mdexdev01/MatESP32_18x11x2/config_ESP32_S3_N16R8.png

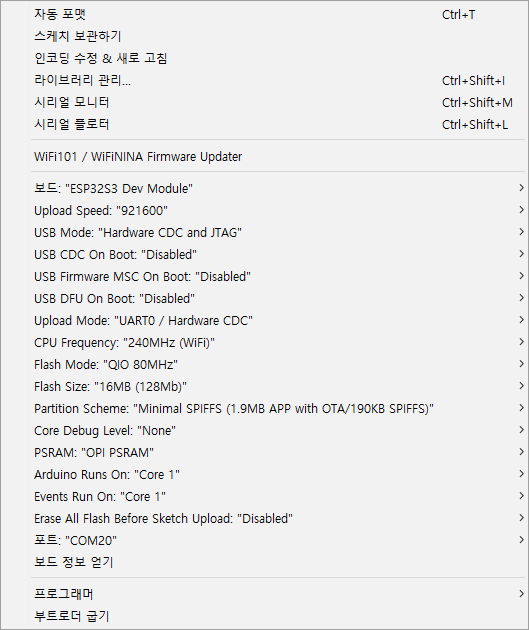
config_ESP32_S3_N16R8.png
