mdexdev01/MatESP32_18x11x2/prj24-brandContents/Proc_BrandCon_10x12x3/Save_ScreenShot/John Doe/20241016-135037_John Doe_MEMO.png

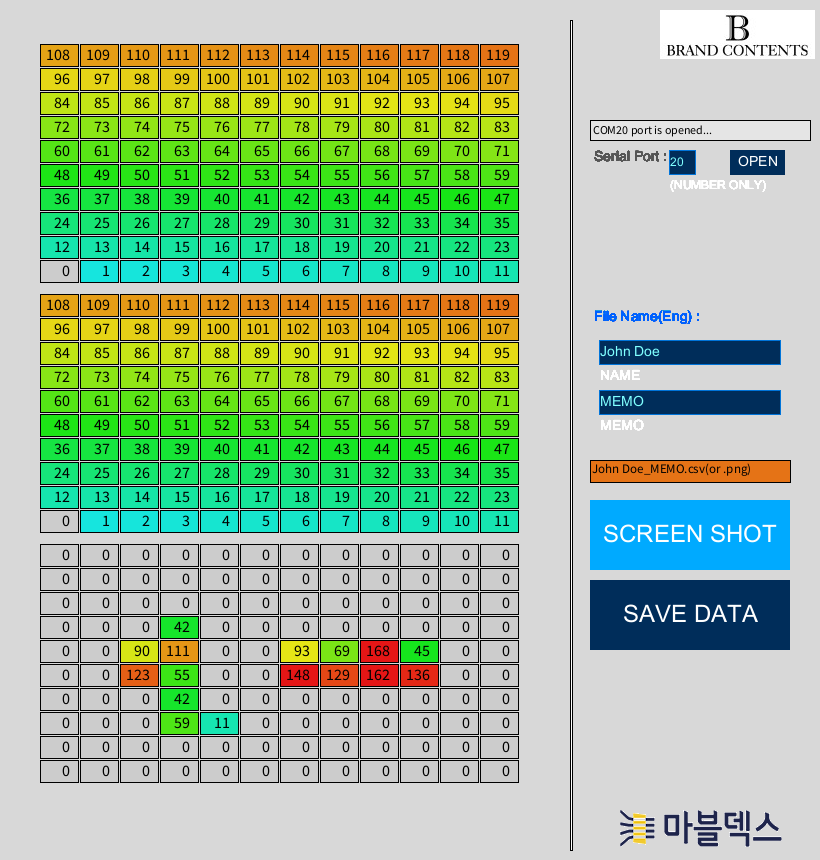
prj24-brandContents/Proc_BrandCon_10x12x3/Save_ScreenShot/John Doe/20241016-135037_John Doe_MEMO.png
