mdexdev01/MatESP32_18x11x2/prj24-luxtep-MAT_V3/Resources/image-dip, tact, buzzer.jpg

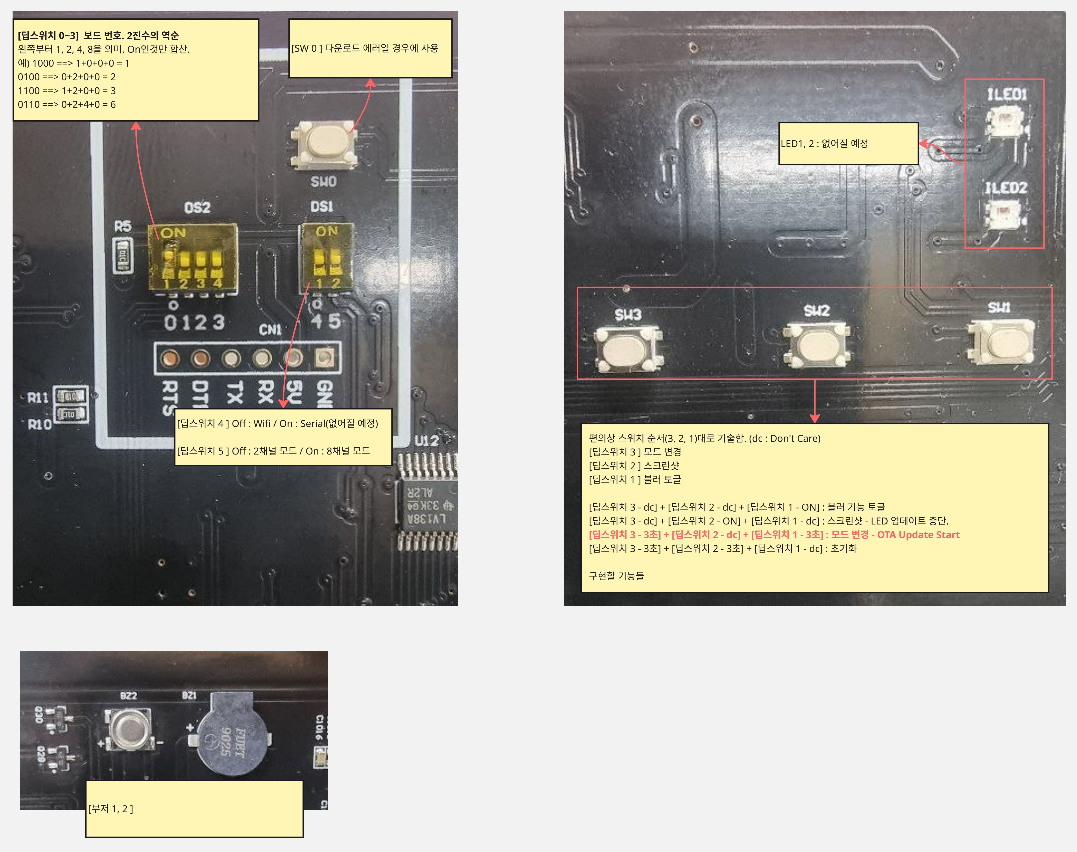
prj24-luxtep-MAT_V3/Resources/image-dip, tact, buzzer.jpg
