mdexdev01/MatESP32_18x11x2/prj24-luxtep-MAT_V3/Resources/luxtep-밟은사진-01.jpg

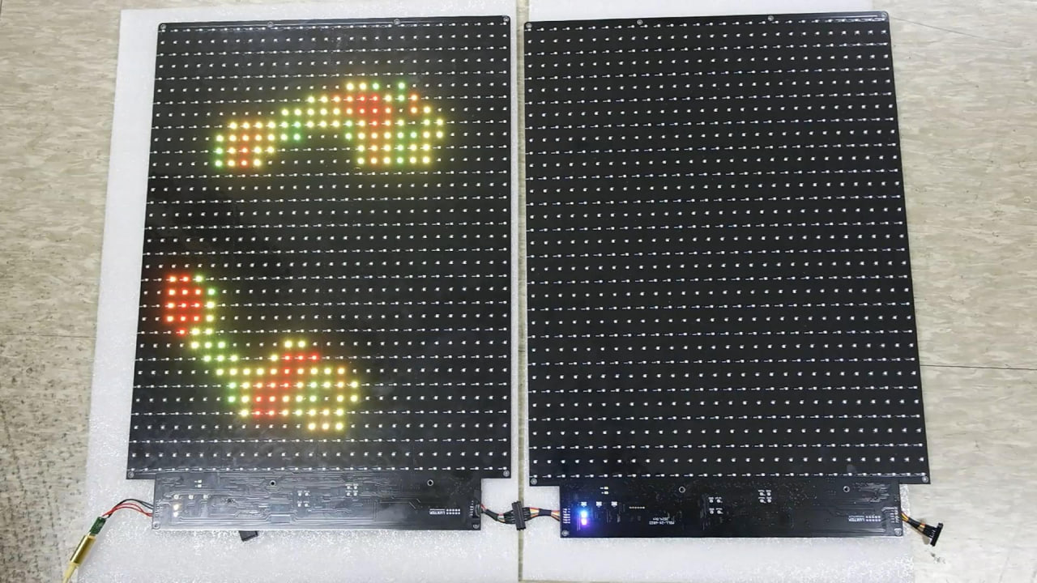
prj24-luxtep-MAT_V3/Resources/luxtep-밟은사진-01.jpg
