mdexdev01/MatESP32_18x11x2/prj24-luxtep-MAT_V3/Resources/USB PD trigger module.jpg

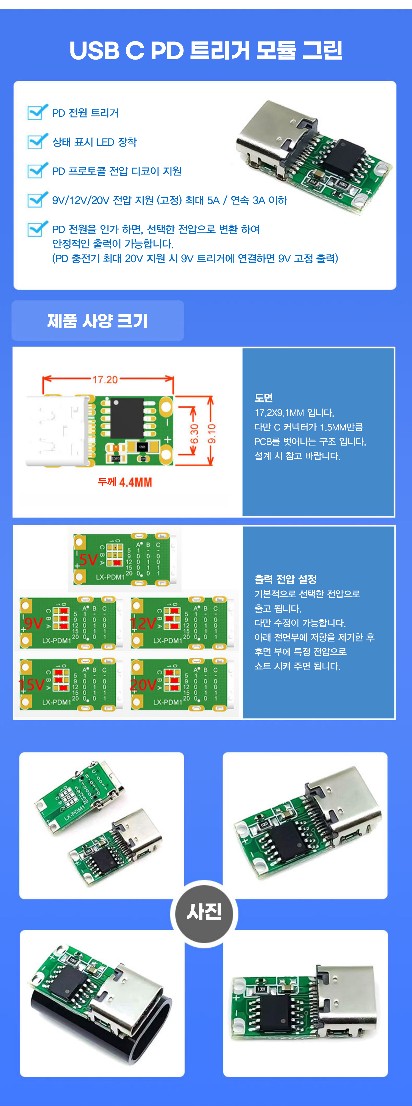
prj24-luxtep-MAT_V3/Resources/USB PD trigger module.jpg
