mdexdev01/MatESP32_18x11x2/prj24-luxtep-MAT_V3/Resources/Part List MDLL-24-6822 Rev1.0 20241112.xlsx

Sheet: Bill of Materials-PCB_MDLL-24-6
No. | Comment | Description | Designator | Quantity | MFPN | Manufacturer | Remark
1 | BLM21PG221SN1 |  | BD1 | 1 | BLM21PG221SN1D | muRata | https://www.lcsc.com/product-detail/Ferrite-Beads_Murata-Electronics-BLM21PG221SN1D_C85840.html
2 | FUET-9025 | DC Buzzer, 2.7KHz | BZ1 | 1 | FUET-9025-3.6V | FUET | https://www.lcsc.com/product-detail/Buzzers_FUET-FUET-9025-3-6V_C417432.html
3 | FUET-5018 | DC Buzzer, 4KHz | BZ2 | 1 | FUET-5018 | FUET | https://www.lcsc.com/product-detail/Buzzers_FUET-FUET-5018_C391028.html
4 | 104 | Cap 1608 | C0, C1, C2, C3, C4, C5, C6, C7, C8, C9, C10, C11, C12, C13, C14, C15, C16, C17, C18, C19, C20, C21, C22, C23, C24, C25, C26, C27, C28, C29, C30, C31, C32, C33, C34, C35, C36, C37, C38, C39, C40, C41, C42, C43, C44, C45, C46, C47, C48, C49, C50, C51, C52, C53, C54, C55, C56, C57, C58, C59, C60, C61, C62, C63, C64, C65, C66, C67, C68, C69, C70, C71, C72, C73, C74, C75, C76, C77, C78, C79, C80, C81, C82, C83, C84, C85, C86, C87, C88, C89, C90, C91, C92, C93, C94, C95, C96, C97, C98, C99, C100, C101, C102, C103, C104, C105, C106, C107, C108, C109, C110, C111, C112, C113, C114, C115, C116, C117, C118, C119, C120, C121, C122, C123, C124, C125, C126, C127, C128, C129, C130, C131, C132, C133, C134, C135, C136, C137, C138, C139, C140, C141, C142, C143, C144, C145, C146, C147, C148, C149, C150, C151, C152, C153, C154, C155, C156, C157, C158, C159, C160, C161, C162, C163, C164, C165, C166, C167, C168, C169, C170, C171, C172, C173, C174, C175, C176, C177, C178, C179, C180, C181, C182, C183, C184, C185, C186, C187, C188, C189, C190, C191, C192, C193, C194, C195, C196, C197, C198, C199, C200, C201, C202, C203, C204, C205, C206, C207, C208, C209, C210, C211, C212, C213, C214, C215, C216, C217, C218, C219, C220, C221, C222, C223, C224, C225, C226, C227, C228, C229, C230, C231, C232, C233, C234, C235, C236, C237, C238, C239, C240, C241, C242, C243, C244, C245, C246, C247, C248, C249, C250, C251, C252, C253, C254, C255, C256, C257, C258, C259, C260, C261, C262, C263, C264, C265, C266, C267, 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 | 1004 | TCC0603X7R104K500CT | CCTC | https://www.lcsc.com/product-detail/Multilayer-Ceramic-Capacitors-MLCC-SMD-SMT_CCTC-TCC0603X7R104K500CT_C282519.html
5 | 106 | Cap 1608, 10V | C993, C1013, C1016 | 3 | C1608JB1A106K080AC 대치품 CL10A106KP8NNNC | TDK Samsung Electro-Mechanics | https://www.lcsc.com/product-detail/Multilayer-Ceramic-Capacitors-MLCC-SMD-SMT_Samsung-Electro-Mechanics-CL10A106KP8NNNC_C19702.html
6 | 101 | Cap 1608 | C998, C1000, C1002, C1003, C1006 | 5 | 0603CG101J500NT | FH | https://www.lcsc.com/product-detail/Multilayer-Ceramic-Capacitors-MLCC-SMD-SMT_FH-Guangdong-Fenghua-Advanced-Tech-0603CG101J500NT_C1635.html
7 | 102 | Cap 1608 | C999, C1004, C1005 | 3 | CC0603KRX7R7BB102 | YAGEO | https://www.lcsc.com/product-detail/Multilayer-Ceramic-Capacitors-MLCC-SMD-SMT_YAGEO-CC0603KRX7R7BB102_C519403.html
8 | 106/10V | Cap 1608, 10V | C1007, C1009, C1018, C1019 | 4 | C1608JB1A106K080AC 대치품 CL10A106KP8NNNC | TDK Samsung Electro-Mechanics | https://www.lcsc.com/product-detail/Multilayer-Ceramic-Capacitors-MLCC-SMD-SMT_Samsung-Electro-Mechanics-CL10A106KP8NNNC_C19702.html
9 | 104/63V | Cap 2012, 63V | C1011, C1012 | 2 | CC0805KRX7R9BB104 | YAGEO | https://www.lcsc.com/product-detail/Multilayer-Ceramic-Capacitors-MLCC-SMD-SMT_YAGEO-CC0805KRX7R9BB104_C49678.html
10 | 2.54mm 6P |  | CN1 | 1 |  |  | No use
11 | 2.54mm 6P |  | CN2, CN3 | 2 |  |  | No use (6핀 커넥터 wire 수작업 납땜)
12 | BS5819WS |  | D1, D3 | 2 | B5819WS | LGE | https://www.lcsc.com/product-detail/Schottky-Diodes_LGE-B5819WS_C402231.html
13 | SS34 | 40V 3A (DO-214AC) | D2 | 1 | SS34 | LGE | https://www.lcsc.com/product-detail/Schottky-Diodes_LGE-SS34_C432300.html
14 | TU-02 |  | DS1 | 1 | TU-02 | Yuandi | https://www.lcsc.com/product-detail/DIP-Switches_Yuandi-TU-02_C7419812.html
15 | TU-04 |  | DS2 | 1 | TU-04 | Yuandi | https://www.lcsc.com/product-detail/DIP-Switches_Yuandi-TU-04_C7419814.html
16 | 22uF/63V (L=6mm 이하) | Cap Elec | EC1, EC2, EC3, EC4, EC5 | 5 | SHTL63V220MF077 대치품 EFVH063ADA220M0654 VMMC0571J220MV | Meritek FOLLON Ymin | https://www.lcsc.com/product-detail/Aluminum-Electrolytic-Capacitors-SMD_FOLLON-EFVH063ADA220M0654_C22388011.html
17 | 220uF/16V | Cap Elec | EC6, EC7, EC8, EC9 | 4 | RX220UF16V90RV0106 | KNSCHA | https://www.lcsc.com/product-detail/Aluminum-Electrolytic-Capacitors-SMD_KNSCHA-RX220UF16V90RV0106_C3445239.html
18 | FSMD020-60-R | PTC Resettable fuse, 60V 0.4A | F1 | 1 | FSMD020-60-R | Fuzetec Tech | https://www.lcsc.com/product-detail/Resettable-Fuses_Fuzetec-Tech-FSMD020-60-R_C224191.html
19 | HOLE |  | H1, H2, H3, H4, H5, H6, H7, H8 | 8 |  |  | No use
20 | WS2812C-2020 | RGB control LED | ILED1, ILED2, LED0, LED1, LED2, LED3, LED4, LED5, LED6, LED7, LED8, LED9, LED10, LED11, LED12, LED13, LED14, LED15, LED16, LED17, LED18, LED19, LED20, LED21, LED22, LED23, LED24, LED25, LED26, LED27, LED28, LED29, LED30, LED31, LED32, LED33, LED34, LED35, LED36, LED37, LED38, LED39, LED40, LED41, LED42, LED43, LED44, LED45, LED46, LED47, LED48, LED49, LED50, LED51, LED52, LED53, LED54, LED55, LED56, LED57, LED58, LED59, LED60, LED61, LED62, LED63, LED64, LED65, LED66, LED67, LED68, LED69, LED70, LED71, LED72, LED73, LED74, LED75, LED76, LED77, LED78, LED79, LED80, LED81, LED82, LED83, LED84, LED85, LED86, LED87, LED88, LED89, LED90, LED91, LED92, LED93, LED94, LED95, LED96, LED97, LED98, LED99, LED100, LED101, LED102, LED103, LED104, LED105, LED106, LED107, LED108, LED109, LED110, LED111, LED112, LED113, LED114, LED115, LED116, LED117, LED118, LED119, LED120, LED121, LED122, LED123, LED124, LED125, LED126, LED127, LED128, LED129, LED130, LED131, LED132, LED133, LED134, LED135, LED136, LED137, LED138, LED139, LED140, LED141, LED142, LED143, LED144, LED145, LED146, LED147, LED148, LED149, LED150, LED151, LED152, LED153, LED154, LED155, LED156, LED157, LED158, LED159, LED160, LED161, LED162, LED163, LED164, LED165, LED166, LED167, LED168, LED169, LED170, LED171, LED172, LED173, LED174, LED175, LED176, LED177, LED178, LED179, LED180, LED181, LED182, LED183, LED184, LED185, LED186, LED187, LED188, LED189, LED190, LED191, LED192, LED193, LED194, LED195, LED196, LED197, LED198, LE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 | 982 | WS2812C-2020-V1 | Worldsemi | https://www.lcsc.com/product-detail/RGB-LEDs-Built-in-IC_Worldsemi-WS2812C-2020-V1_C2976072.html
21 | 100uH | Inductor 12.5x12.5x6mm | L1 | 1 | HX CYH125-100UH | hanxia | https://www.lcsc.com/product-detail/Inductors-SMD_hanxia-HX-CYH125-100UH_C7587713.html
22 | ESP32-S3-WROOM-1-N16R8 | ESP32-S3, N16R8 | MCU1 | 1 | ESP32-S3-WROOM-1-N16R8 | ESPRESSIF | https://www.lcsc.com/product-detail/WiFi-Modules_Espressif-Systems-ESP32-S3-WROOM-1-N16R8_C2913202.html
23 | Test Pin |  | PAD1, PAD2 | 2 |  |  | No use
24 | KRC105S | NPN with resistor | Q0, Q1, Q2, Q3, Q4, Q5, Q6, Q7, Q8, Q9, Q10, Q11, Q12, Q13, Q14, Q15, Q16, Q17, Q18, Q19, Q20, Q21, Q22, Q23, Q24, Q25, Q26, Q27, Q28, Q30 | 30 | KRC105S-RTK/P | KEC Semicon | https://www.lcsc.com/product-detail/Bipolar-BJT_KEC-Semicon-KRC105S-RTK-P_C112793.html
25 | MMBT2222A |  | Q29, Q31 | 2 | MMBT2222A | IDCHIP | https://www.lcsc.com/product-detail/Bipolar-BJT_IDCHIP-MMBT2222A_C7463414.html
26 | 1K | Resistor 1608, 1% | R1, R7, R8, R11, R17, R28, R29, R31 | 8 | RC0603FR-071KP 대치품 RC0603FR-071KL | YAGEO YAGEO | https://www.lcsc.com/product-detail/Chip-Resistor-Surface-Mount_YAGEO-RC0603FR-071KL_C22548.html
27 | 10K | Resistor 1608, 1% | R2, R3, R4, R5, R9, R10, R12, R13, R14, R18, R23 | 11 | RC0603FR-0710KP 대치품 FRC0603F1002TS | YAGEO FOJAN | https://www.lcsc.com/product-detail/Chip-Resistor-Surface-Mount_FOJAN-FRC0603F1002TS_C2906982.html
28 | 100 | Resistor 1608, 1% | R6 | 1 | RC0603FR-07100RL | YAGEO | https://www.lcsc.com/product-detail/Chip-Resistor-Surface-Mount_YAGEO-RC0603FR-07100RL_C105588.html
29 | 4.7K | Resistor 1608, 1% | R15, R26 | 2 | RC0603FR-074K7L | YAGEO | https://www.lcsc.com/product-detail/Chip-Resistor-Surface-Mount_YAGEO-RC0603FR-074K7L_C99782.html
30 | 10 | Resistor 1608, 1% | R16, R25 | 2 | RC0603FR-0710RL | YAGEO | https://www.lcsc.com/product-detail/Chip-Resistor-Surface-Mount_YAGEO-RC0603FR-0710RL_C109318.html
31 | 47 | Resistor 1608, 1% | R19, R21, R24 | 3 | RC0603FR-0747RL | YAGEO | https://www.lcsc.com/product-detail/Chip-Resistor-Surface-Mount_YAGEO-RC0603FR-0747RL_C114623.html
32 | NC | 2012, NC | R20 | 1 |  | YAGEO | No use
33 | NC | Resistor 1608, 1% | R22 | 1 |  | YAGEO | No use
34 | 20K | Resistor 1608, 1% | R27 | 1 | RC0603FR-0720KL | YAGEO | https://www.lcsc.com/product-detail/Chip-Resistor-Surface-Mount_YAGEO-RC0603FR-0720KL_C105575.html
35 | 499 | Resistor 1608, 1% | R30 | 1 | RC0603FR-07499RL | YAGEO | https://www.lcsc.com/product-detail/Chip-Resistor-Surface-Mount_YAGEO-RC0603FR-07499RL_C137714.html
36 | 10R | Resistor 1608, 0.1% | R32 | 1 | RT0603BRD0710RL | YAGEO | https://www.lcsc.com/product-detail/Chip-Resistor-Surface-Mount_YAGEO-RT0603BRD0710RL_C861082.html
37 | 0R | Resistor 1608, 1% | R33 | 1 | RC0603FR-130RL 대치품 AC0603FR-070RL | YAGEO | https://www.lcsc.com/product-detail/Chip-Resistor-Surface-Mount_YAGEO-AC0603FR-070RL_C116699.html
38 | SEN_POINT | Sensor Point | SP0, SP1, SP2, SP3, SP4, SP5, SP6, SP7, SP8, SP9, SP10, SP11, SP12, SP13, SP14, SP15, SP16, SP17, SP18, SP19, SP20, SP21, SP22, SP23, SP24, SP25, SP26, SP27, SP28, SP29, SP30, SP31, SP32, SP33, SP34, SP35, SP36, SP37, SP38, SP39, SP40, SP41, SP42, SP43, SP44, SP45, SP46, SP47, SP48, SP49, SP50, SP51, SP52, SP53, SP54, SP55, SP56, SP57, SP58, SP59, SP60, SP61, SP62, SP63, SP64, SP65, SP66, SP67, SP68, SP69, SP70, SP71, SP72, SP73, SP74, SP75, SP76, SP77, SP78, SP79, SP80, SP81, SP82, SP83, SP84, SP85, SP86, SP87, SP88, SP89, SP90, SP91, SP92, SP93, SP94, SP95, SP96, SP97, SP98, SP99, SP100, SP101, SP102, SP103, SP104, SP105, SP106, SP107, SP108, SP109, SP110, SP111, SP112, SP113, SP114, SP115, SP116, SP117, SP118, SP119, SP120, SP121, SP122, SP123, SP124, SP125, SP126, SP127, SP128, SP129, SP130, SP131, SP132, SP133, SP134, SP135, SP136, SP137, SP138, SP139, SP140, SP141, SP142, SP143, SP144, SP145, SP146, SP147, SP148, SP149, SP150, SP151, SP152, SP153, SP154, SP155, SP156, SP157, SP158, SP159, SP160, SP161, SP162, SP163, SP164, SP165, SP166, SP167, SP168, SP169, SP170, SP171, SP172, SP173, SP174, SP175, SP176, SP177, SP178, SP179, SP180, SP181, SP182, SP183, SP184, SP185, SP186, SP187, SP188, SP189, SP190, SP191, SP192, SP193, SP194, SP195, SP196, SP197, SP198, SP199, SP200, SP201, SP202, SP203, SP204, SP205, SP206, SP207, SP208, SP209, SP210, SP211, SP212, SP213, SP214, SP215, SP216, SP217, SP218, SP219, SP220, SP221, SP222, SP223, SP224, SP225, SP226, SP227, SP228, SP229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 | 952 |  |  | No use
39 | K2-1808SN-A3SW-01 | Tact switch, 1 contact | SW0, SW1, SW2, SW3 | 4 | K2-1808SN-A3SW-01 | Korean Hroparts Elec | https://www.lcsc.com/product-detail/Tactile-Switches_Korean-Hroparts-Elec-K2-1808SN-A3SW-01_C2690012.html
40 | Test Pin |  | TP1, TP2, TP3, TP4 | 4 |  |  | No use (예비 : 5V 전원 수작업 납땜)
41 | SMBJ5.0CA |  | TVS1, TVS2, TVS3 | 3 | SMBJ5.0CA | SETsafe | SETfuse | https://www.lcsc.com/product-detail/ESD-and-Surge-Protection-TVS-ESD_SETsafe-SETfuse-SMBJ5-0CA_C3009995.html
42 | NX3L4051HR | CMOS Logic | U1, U2, U3, U4, U5, U6, U7, U8, U9 | 9 | NX3L4051HRZ | NXP Semicon | https://www.mouser.kr/ProductDetail/NXP-Semiconductors/NX3L4051HRZ?qs=rkhjVJ6%2F3ELzN1WurobGoA%3D%3D
43 | SN74LV138APWR | 3 to 8 Line Decoder | U10, U11, U12, U13 | 4 | SN74LV138APWR | Texas Instruments | https://www.lcsc.com/product-detail/Signal-Switches-Multiplexers-Decoders_Texas-Instruments-SN74LV138APWR_C388287.html
44 | OP07CD | OP-AMP, SOIC 8P | U14 | 1 | OP07CD | Texas Instruments | https://www.lcsc.com/product-detail/Precision-Op-Amps_Texas-Instruments-OP07CD_C354130.html
45 | MAX3485 |  | U15 | 1 | MAX3485EESA+T | Analog Devices Inc./Maxim Integrated | https://www.lcsc.com/product-detail/RS-span-style-background-color-ff0-485-span-RS-422-ICs_Analog-Devices-Inc-Maxim-Integrated-MAX3485EESA-T_C9943.html
46 | INA821IDR | 35uV offset, 4~36V Single & Dual power | U16 | 1 | INA821IDR | Texas Instruments | https://www.lcsc.com/product-detail/Instrumentation-Amplifiers_Texas-Instruments-INA821IDR_C2060822.html
47 | LM2576-5.0WU | Vin 40Vmax, 3.3V/3A output, TO-263 | U17 | 1 | LM2576-5.0WU | Microchip Tech | https://www.lcsc.com/product-detail/DC-DC-Converters_Microchip-Tech-LM2576-5-0WU_C641104.html
48 | LM1117-3.3 | 3.3V SOT-223 | U18 | 1 | LD1117-3.3 | UMW(Youtai Semiconductor Co., Ltd.) | https://www.lcsc.com/product-detail/Voltage-Regulators-Linear-Low-Drop-Out-LDO-Regulators_UMW-Youtai-Semiconductor-Co-Ltd-LD1117-3-3_C347229.html
49 | TL7660CDR | CMOS Voltage Converter | U19 | 1 | TL7660CDR | Texas Instruments | https://www.lcsc.com/product-detail/Charge-Pumps_Texas-Instruments-TL7660CDR_C130206.html

Sheet: Sheet1
 | Purchase (Set) | Ass'y (Set)
Components | 24 | 24
Cable (M/F) | 50 | 24
 | PCB Qty | Ass'y |  | MG0622F-SOLDER (O) | MG0622F-SOLDER (X) 솔더링 없이 그냥 놔두세요. | MG0622M-SOLDER (O)
1.6mm PCB | 5 | 4 |  | 2 | 2 | 4 (All)
2.0mm PCB | 20 | 20 |  | 16 | 4 | 20 (All)
 |  | 송부할 하네스 개수 |  | MG0622F | MG0622M
 |  |  | 구매 수량 | 50 | 50
 |  |  | 1차 조립에 투입 | 18 | 24
 |  |  | 단품으로 배송 | 8 | 2
 |  |  | 잔여 수량 | 24 | 24
