mdexdev01/MatESP32_18x11x2/prj24-luxtep-MAT_V3/RequirementsHistory.md

#요구 사항 처리 기록
---

# 2025.08.01

네이밍에 문제가 있음. 다음의 순서대로 개선할 예정

1. 명명 규칙 및 코드 스타일 리팩토링
2. loopADCRead 함수를 여러 함수로 분화
3. 전역변수 사용 억제
4. delay() 대신 vTaskDelay()를 사용
5. ESP32 펌웨어 내 비효율성 해소 : 태스크 동기화 및 순차 처리, Busy-Waiting(사실상 Polling) 배제
