mdexdev01/MatESP32_18x11x2/prj23-grib-ble/TODO-prj23-grib-ble.txt

230728
	Device name ? currently, it's "Grib".

  <TODO>
  RLE
  ADV, 
  BLE with RLE, 
  Deliver SUB with RLE
  Receive Button input
