mdexdev01/MatESP32_18x11x2/prj24-brandContentsExp-LGD/sch/ESP32-S3_RS485.pdf

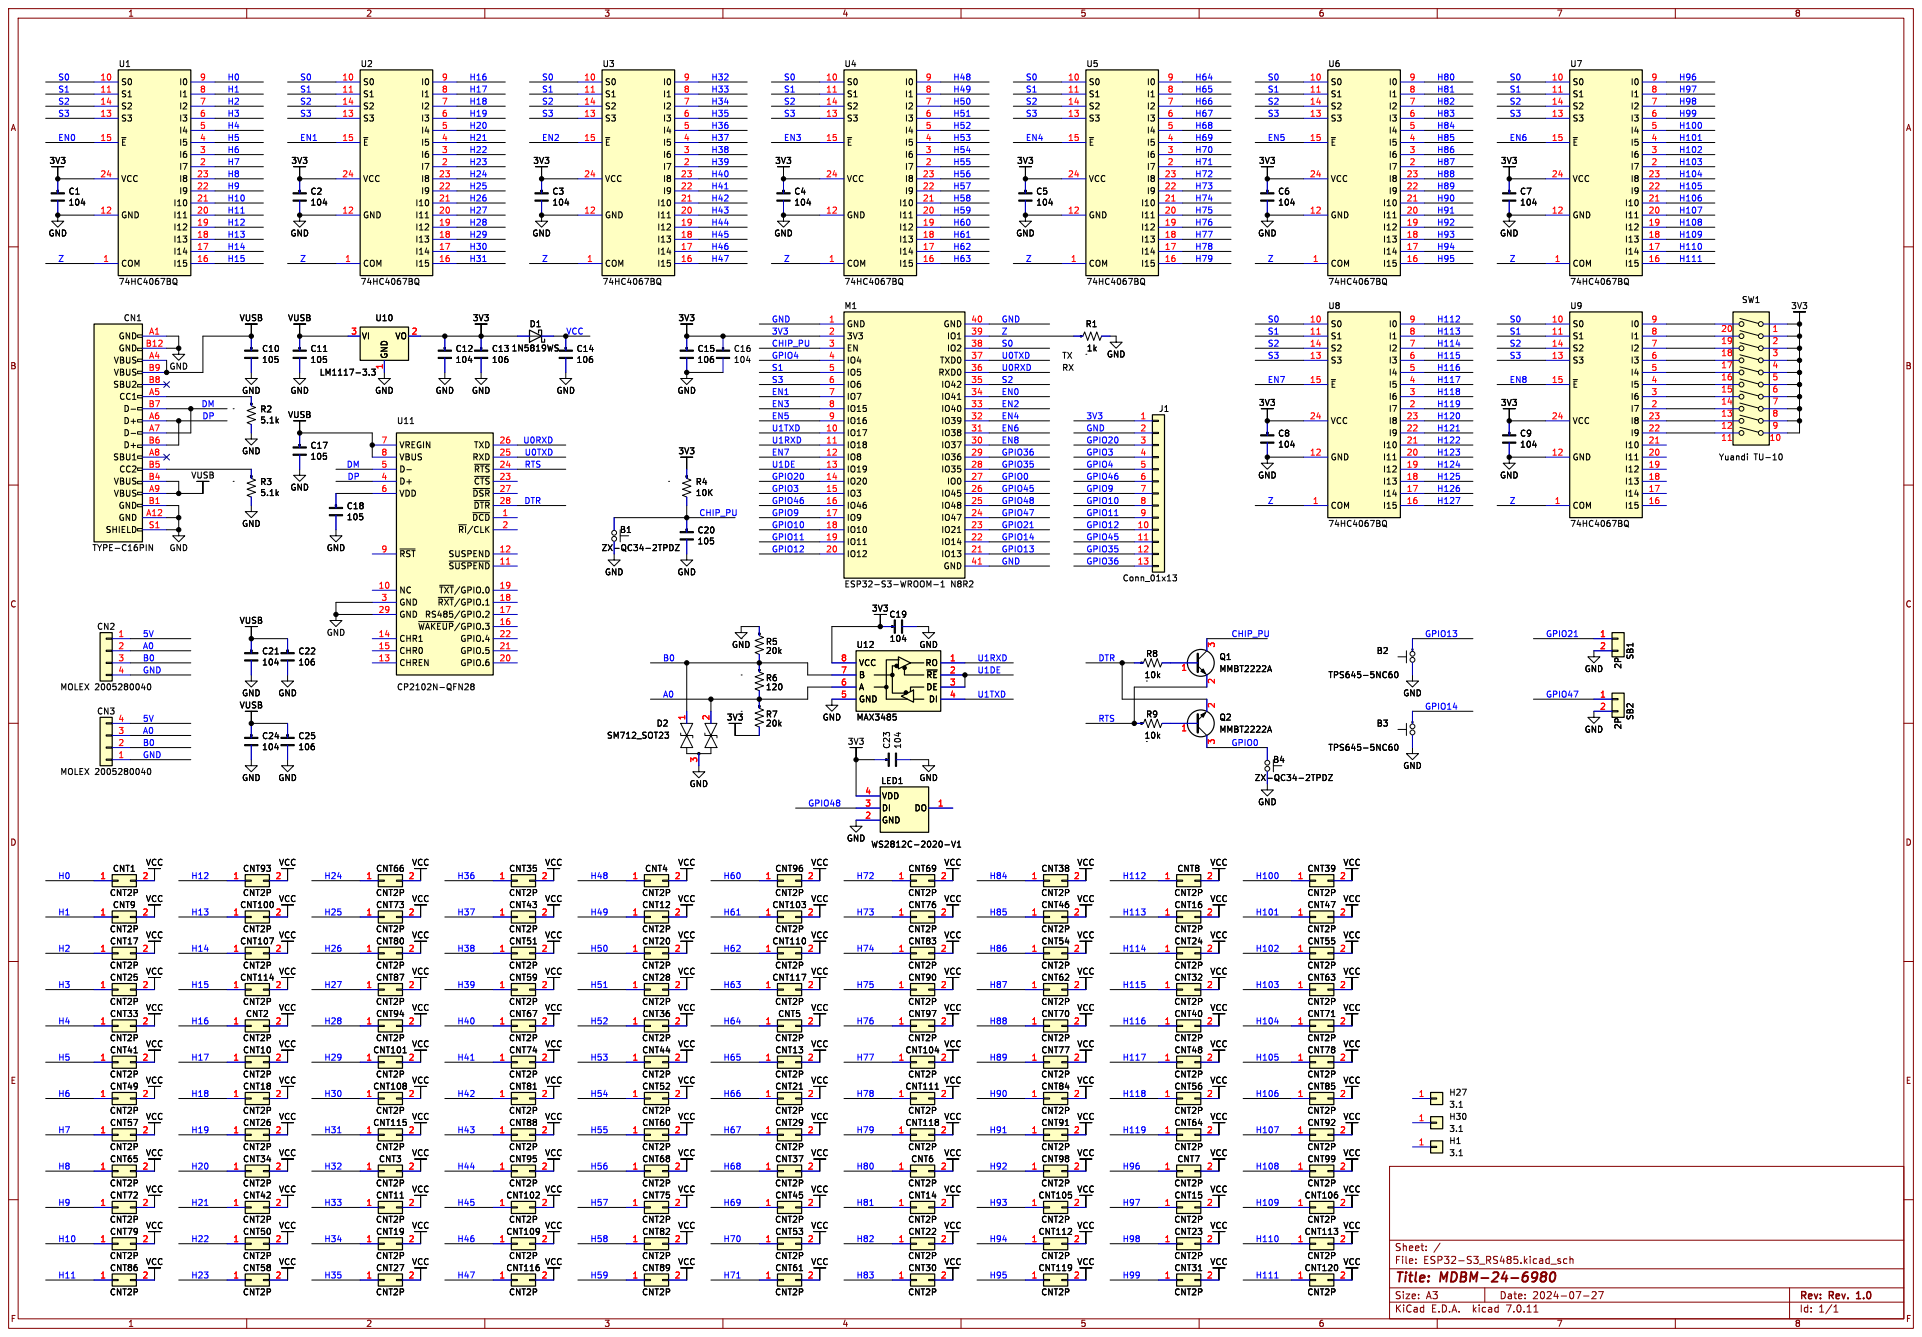
[picture p7: page 1]
