mdexdev01/MatESP32_18x11x2/prj24-luxtep-MAT_V3/pio_Luxtep_03/components/driver_28x35/configPins-mdll-24-6822.h

#ifndef _CONFIGPINS_H_
#define _CONFIGPINS_H_

#include <Arduino.h>
#include <driver/adc.h>
#include <driver/gpio.h>

#include "libPrintRaw.h"
//   rs485 - rxd, txd, de

//   dip switch - opt 0, 1 [GPIO]
//   OPT0 : MAIN OR SUB
//   OPT1 : NONE

//   dip switch - A 0, 1, 2, 3 [GPIO]
//   SWA0 :

//  LED indicator

//----------------------------------------------------
//  MDLL-24-6822 Pinout
//----------------------------------------------------
//  4067 selection pins
//  Num of Mux output
#define MUX_74HC4067_OUT 16
#define MUX_74HC4067_HALF_OUT 8
#define MUX_74HC4051_OUT 8

#define NUM_MUX_OUT MUX_74HC4051_OUT

//-------------------------------------------------------------
//   MUX, POWER[28] - NX3L4051HR power  [S0 ~ S2, Z, EN0~EN3] : EXT0~EXT27,
//  Mux for Ext power - NX3L4051HR
const int NUM_MUX_SIG = 3;
#define pinExtS0 4
#define pinExtS1 5
#define pinExtS2 6
int pinMuxPwrSig012[NUM_MUX_SIG] = {pinExtS0, pinExtS1, pinExtS2};

const int NUM_PWR_MUX = 4;
#define pinExtEn0 20
#define pinExtEn1 3
#define pinExtEn2 46
#define pinExtEn3 9
int pinMuxPwrEn[NUM_PWR_MUX] = {pinExtEn0, pinExtEn1, pinExtEn2, pinExtEn3};
int ext_mux_id_prev = -1;

//-------------------------------------------------------------
//   MUX, INPUT[34]  - NX3L4051HR input  [AN0~AN2, Z, EN4~EN8] : SEN0~SEN33,, SW-OPT0, 1,, SW-A0~A3
//  Mux for Sensor - NX3L4051HR
#define pinSenS0 42  //  AN0
#define pinSenS1 41  //  AN1
#define pinSenS2 40  //  AN2
int pinMuxSenSig012[NUM_MUX_SIG] = {pinSenS0, pinSenS1, pinSenS2};

const int NUM_SEN_MUX = 5;
#define pinSenEn0 10
#define pinSenEn1 11
#define pinSenEn2 12
#define pinSenEn3 39
#define pinSenEn4 38
int pinMuxSenEn[NUM_SEN_MUX] = {pinSenEn0, pinSenEn1, pinSenEn2, pinSenEn3, pinSenEn4};
int en_sen_mux_id = -1;

//-------------------------------------------------------------
//   adc - aref [ADC]
//   adc - aout [ADC]
// #define pinVOut 1  //  ADC1_0
// #define pinVRef 2  //  ADC1_1
#define pinVOut ADC1_CHANNEL_0  // GPIO 1, ADC1_0, printed as 0
#define pinVRef ADC1_CHANNEL_1  // GPIO 2, ADC1_1, printed as 1

//  ADC Buffer
#define NUM_PWR 28  // X
#define NUM_SEN 34  // Y

#define NUM_COL NUM_PWR  // X, 28, SIZE_X
#define NUM_ROW NUM_SEN  // Y, 34, SIZE_Y

#define SIZE_X NUM_COL
#define SIZE_Y NUM_ROW

//  ADC Buffer used by hardware
int VOut_Value[NUM_PWR][NUM_SEN];
int VRef_Value[NUM_PWR][NUM_SEN];
int calcedVolt[NUM_PWR][NUM_SEN];
int backupVolt[NUM_PWR][NUM_SEN];

//  Force buffer used by hardware
byte hwForceBuf_odd[SIZE_X * SIZE_Y];
byte hwForceBuf_even[SIZE_X * SIZE_Y];

//  Force buffer pointer used by software
byte* forceBuffer_rd = hwForceBuf_odd;
byte* forceBuffer_wr = hwForceBuf_even;
byte* forceBuffer_wr_last = forceBuffer_rd;

//  Force Buffer from board 1
byte forceBuffer_bd1[SIZE_X * SIZE_Y];

//  Dip Switch
int MY_BOARD_ID = 0;  // 0: Main, 1: Sub

// XXXXXXXXXXXXXXXXXXXXXXXXXXXXXXXXXXXXXXXXXXXXXXXXXXXXXXXXXXXXXXXXXXX
//------------------------------------
//  DIP SWITCH
#define NUM_OF_DIP 6
boolean dip_state[NUM_OF_DIP];

//-------------------------------------------------------------
//   TACT - 1, 2, 3 [GPIO]

//-------------------------------------------------------------
//   BUZZER 1, 2 [PWM]
#define BZ1_CTL 7
#define BZ2_CTL 15

//-------------------------------------------------------------
//  LED strip - DI0~DI3
// #define DI0 47
#define DI0 8
#define DI1 21
#define DI2 14
#define DI3 13

///////////////////////////////////////////////////////////////////////////
//    SETUP
///////////////////////////////////////////////////////////////////////////
void setup_MeasureBuffers() {
    for (int i = 0; i < NUM_PWR; i++) {
        memset(VOut_Value[i], 0, NUM_SEN);
        memset(VRef_Value[i], 0, NUM_SEN);

        memset(calcedVolt[i], 0, NUM_SEN);
        memset(backupVolt[i], 0, NUM_SEN);
    }

    memset(hwForceBuf_odd, 0, SIZE_X * SIZE_Y);
    memset(hwForceBuf_even, 0, SIZE_X * SIZE_Y);
    memset(forceBuffer_bd1, 0, SIZE_X * SIZE_Y);
}

//  HW Pin # - Wakeup, ADC
#define RESOLUTION_BITS (12)  // choose resolution (explained in depth below)

void setup_HWPins_34x28() {
    pinMode(LED_BUILTIN, OUTPUT);

    // LED matrix
    pinMode(DI0, OUTPUT);
    pinMode(DI1, OUTPUT);
    pinMode(DI2, OUTPUT);
    pinMode(DI3, OUTPUT);

    pinMode(pinVOut, INPUT);
    pinMode(pinVRef, INPUT);

    //  - maximum: 14 bits (maximum ADC resolution)
    //  - default: 10 bits (standard Arduino setting)
    //  - minimum:  1 bit
    analogReadResolution(RESOLUTION_BITS);  // set the resolution of analogRead results
    // adc1_config_width(ADC_WIDTH_BIT_12);                  // 9비트 해상도 설정
    // adc1_config_channel_atten(pinVOut, ADC_ATTEN_DB_11);  // 감쇠 설정 (필요에 따라 조정)
    // adc1_config_channel_atten(pinVRef, ADC_ATTEN_DB_11);  // 감쇠 설정 (필요에 따라 조정)

    for (int i = 0; i < NUM_MUX_SIG; i++) {
        pinMode(pinMuxPwrSig012[i], OUTPUT);
        digitalWrite(pinMuxPwrSig012[i], LOW);
        // pinMode(pinMuxLatSel[i], OUTPUT);
        // digitalWrite(pinMuxLatSel[i], LOW);
        pinMode(pinMuxSenSig012[i], OUTPUT);
        digitalWrite(pinMuxSenSig012[i], LOW);
    }

    for (int i = 0; i < NUM_PWR_MUX; i++) {
        pinMode(pinMuxPwrEn[i], OUTPUT);
        digitalWrite(pinMuxPwrEn[i], HIGH);
    }

    for (int i = 0; i < NUM_SEN_MUX; i++) {
        pinMode(pinMuxSenEn[i], OUTPUT);
        digitalWrite(pinMuxSenEn[i], HIGH);
    }

    delay(1);
}

//-----------------------------------------------------
//    READ ADC WITH MUX
//-----------------------------------------------------
int loop_gpio_count = 0;

int muxSig3PinsVal[NUM_MUX_OUT][NUM_MUX_SIG] = {
    // [Mux Output : 0~7][Signal Pin : 0~2]
    //  {S0,S1,S2}
    {0, 0, 0},  // channel 0
    {1, 0, 0},  // channel 1
    {0, 1, 0},  // channel 2
    {1, 1, 0},  // channel 3   It means S0=1, S1=1, S2=0
    {0, 0, 1},  // channel 4
    {1, 0, 1},  // channel 5
    {0, 1, 1},  // channel 6
    {1, 1, 1},  // channel 7
};

//-----------------------------------------------------
//    MUX WORKING - EXT
//-----------------------------------------------------
void selectPwrMux(int ext_mux_id) {
    if (ext_mux_id_prev == ext_mux_id)
        return;

    // for (int i = 0; i < NUM_PWR_MUX; i++) {
    //     digitalWrite(pinMuxPwrEn[i], HIGH);
    // }

    digitalWrite(pinMuxPwrEn[ext_mux_id_prev], HIGH);  // HIGH disable
    digitalWrite(pinMuxPwrEn[ext_mux_id], LOW);        // LOW enable

    ext_mux_id_prev = ext_mux_id;
}

void selectPwrOut(int ext_ch) {
    // config signal 4 pins
    for (int i = 0; i < NUM_MUX_SIG; i++) {
        digitalWrite(pinMuxPwrSig012[i], muxSig3PinsVal[ext_ch][i]);
    }
}

void selectPwrCh(int ext_ch) {
    int mux_id = ext_ch / MUX_74HC4051_OUT;
    int mux_out = ext_ch % MUX_74HC4051_OUT;
    selectPwrMux(mux_id);
    selectPwrOut(mux_out);
}

//-----------------------------------------------------
//    MUX WORKING - SENSOR
//-----------------------------------------------------
const int NOISE_THRESHOLD = 4;

int calcR(int vout, int vref) {
    // float cur_ref = (float)vref / 1000;  // /1000 = (1/100)/10
    int sensor_R = 0;
    if (vref != 0)
        sensor_R = vout * 1000 / vref;  // /1000 = (1/100)/10
    return sensor_R;
}

int calcF(int vout, int vref) {
    int value_r = calcR(vout, vref);
    int force = 0;
    const int ZERO_ALIGN = 25;
    if (value_r != 0) {
        //	x/24 : 1 , x/2 : 240
        force = 600 * 1000 / value_r;  // 800 * 1000 : arbitrary value, value_r: 24000 ~ 2000

        force -= ZERO_ALIGN;
        if (force <= 3) {  // align zero point
            force = 0;
        }
        if (239 <= force)
            force = 239;
    } else
        return -1;

    return force;
}

void selectSenMux(int sen_mux_id) {
    if (en_sen_mux_id == sen_mux_id)
        return;

    // for (int i = 0; i < NUM_SEN_MUX; i++) {
    //     digitalWrite(pinMuxSenEn[i], HIGH);
    // }

    digitalWrite(pinMuxSenEn[en_sen_mux_id], HIGH);  // old
    digitalWrite(pinMuxSenEn[sen_mux_id], LOW);      // new

    en_sen_mux_id = sen_mux_id;
}

int _vout_raw;
int _vref_raw;
int read1chInSenMux(int mux_ch) {
    // config signal 4 pins
    for (int i = 0; i < NUM_MUX_SIG; i++) {
        digitalWrite(pinMuxSenSig012[i], muxSig3PinsVal[mux_ch][i]);
    }

    _vout_raw = adc1_get_raw(pinVOut);
    _vref_raw = adc1_get_raw(pinVRef);

    return _vout_raw;
}

int readAndCalc(int col_index, int mux_id, int mux_ch, int pin_signal) {
    digitalWrite(pinMuxSenSig012[pin_signal], muxSig3PinsVal[mux_ch][pin_signal]);

    int row_index = mux_id * NUM_MUX_OUT + mux_ch;
    _vout_raw = _vref_raw =0;


    // int64_t cur_snap = esp_timer_get_time();                               // 마이크로초 단위로 타이머 초기화

    VOut_Value[col_index][row_index] = _vout_raw = adc1_get_raw(pinVOut); // <========
    ets_delay_us(20);
    taskYIELD();  // ==> taskYIELD() ==> 1ea: 55 ms (18fps), 2ea: 59 ms (16fps), 3ea: 63 ms (15fps)
    
    // int64_t duration_us = esp_timer_get_time() - cur_snap;

    // int64_t cur_snap2 = esp_timer_get_time();  // 마이크로초 단위로 타이머 초기화

    // taskYIELD();  // ==> taskYIELD() ==> 1ea: 55 ms (18fps), 2ea: 59 ms (16fps), 3ea: 63 ms (15fps)
    VRef_Value[col_index][row_index] = _vref_raw = adc1_get_raw(pinVRef); // <========
    ets_delay_us(20);
    taskYIELD();  // ==> taskYIELD() ==> 1ea: 55 ms (18fps), 2ea: 59 ms (16fps), 3ea: 63 ms (15fps)
    
    // int64_t duration_us2 = esp_timer_get_time() - cur_snap2;

    // DUR1= 38 us(adc1= 2878), DUR2= 26 us, (adc2=    0) ==> 측정 시간이 매우 길다 !

    // if (col_index == 0 && row_index == 0) {
    // uart0_printf("[%8d] DUR1= %lld us(adc1=%5d), DUR2= %lld us, (adc2=%5d) \n",
    //              millis(), duration_us, _vout_raw, duration_us2, _vref_raw);
    // }

    // taskYIELD();  // ==> taskYIELD() ==> 1ea: 55 ms (18fps), 2ea: 59 ms (16fps), 3ea: 63 ms (15fps)

    int calc_value = calcF(_vout_raw, _vref_raw);
    if (calc_value < 0)
        calc_value = 0;

    // if (0 < calc_value) {
    // uart0_printf("[%8d]gara force =%d (X%d, Y%d) -------------------\n", millis(), calc_value, col_index, row_index);
    // uart0_printf("[%8d]resol=%d, vout= %d, vref= %d,calc= %d------------\n", millis(), RESOLUTION_BITS, _vout_raw, _vref_raw, calc_value);
    // }

    //  연속 2회동안 0 이상인지 검사. 이전에 0이었다면 peak noise로 간주
    bool is_noise = false;
    if (0 < calc_value) {
        if (0 < backupVolt[col_index][row_index]) {  // remove noise
            // uart0_printf("[%8d]gara 222 force =%d, backup=%d, (X%d, Y%d) -------------------\n", millis(), calc_value, backupVolt[col_index][row_index], col_index, row_index);
        } else {
            is_noise = true;
        }
    }

    if (calc_value < NOISE_THRESHOLD)
        calcedVolt[col_index][row_index] = calc_value = 0;
    else
        calcedVolt[col_index][row_index] = calc_value - NOISE_THRESHOLD;

    // 만일 peak noise 라면 0으로 강제 지정 ==> ADC, LED 동시 동작시에만 지정.
    // if (is_noise)
    //     calcedVolt[col_index][row_index] = 0;

    //  측정값 백업
    backupVolt[col_index][row_index] = calc_value;

    return calc_value;
}

void readAndCalc_in1Mux(int col_index, int mux_id) {
    int mux_ch = 0;
    for (int i = 0; i < NUM_MUX_SIG; i++) {
        digitalWrite(pinMuxSenSig012[i], muxSig3PinsVal[mux_ch][i]);
    }

    // {0, 0, 0},  // channel 0
    readAndCalc(col_index, mux_id, 0, 0);
    // {1, 0, 0},  // channel 1
    readAndCalc(col_index, mux_id, 1, 0);
    // {1, 1, 0},  // channel 3   It means S0=1, S1=1, S2=0
    readAndCalc(col_index, mux_id, 3, 1);
    // {0, 1, 0},  // channel 2
    readAndCalc(col_index, mux_id, 2, 0);

    // {0, 1, 1},  // channel 6
    readAndCalc(col_index, mux_id, 6, 2);
    // {1, 1, 1},  // channel 7
    readAndCalc(col_index, mux_id, 7, 0);
    // {1, 0, 1},  // channel 5
    readAndCalc(col_index, mux_id, 5, 1);
    // {0, 0, 1},  // channel 4
    readAndCalc(col_index, mux_id, 4, 0);
}

void readSen1Col(int col_index) {
    int num_mux = NUM_ROW / NUM_MUX_OUT;  // 34 / 8 = 4

    //  row : 0~31
    for (int mux_id = 0; mux_id < num_mux; mux_id++) {
        // uart0_printf("muxid : %d (/%d) \n", mux_id, num_mux);
        selectSenMux(mux_id);
        readAndCalc_in1Mux(col_index, mux_id);
    }

    selectSenMux(4);
    for (int i = 0; i < NUM_MUX_SIG; i++) {
        digitalWrite(pinMuxSenSig012[i], muxSig3PinsVal[0][i]);  // out : 0, sigpin : i
    }

    //  row : 32, 33
    readAndCalc(col_index, 4, 0, 0);  // mux id : 4, out : 0, sigpin : 0
    readAndCalc(col_index, 4, 1, 0);  // mux id : 4, out : 1, sigpin : 0
}

void readSenCh(int sen_ch) {
    int mux_id = sen_ch / MUX_74HC4051_OUT;
    int mux_out = sen_ch % MUX_74HC4051_OUT;
    selectSenMux(mux_id);
    read1chInSenMux(mux_out);
}

//	이거 PWR를 고정하고 센서를 움직이는데, 반대로 센서를 고정하고 PWR를 바꾸는 방식으로 수정해야 함.
int adc_scan_count_main = 0;
void adcScan_DoubleBuf() {
    //  for ext mux id loop
    for (int col_pwr = 0; col_pwr < NUM_PWR; col_pwr++) {
    // for (int col_pwr = NUM_PWR - 1; 0 <= col_pwr; col_pwr--) {// 역순 테스트
        selectPwrCh(col_pwr);

        readSen1Col(col_pwr);  // temp
    }  // end - for ext mux id loop

    //  Copy ADC buffer to forceBuffer_rd
    {
        byte* forceBuffer_prev = forceBuffer_rd;

        // uart0_printf("[%8d] copy force buf * ptr:%d \n", millis(), forceBuffer_wr);
        int cell_index = 0;
        for (int y = 0; y < SIZE_Y; y++) {
            for (int x = 0; x < SIZE_X; x++) {
                cell_index = SIZE_X * y + x;

                forceBuffer_wr[cell_index] = calcedVolt[x][y];
            }
        }

        forceBuffer_wr_last = forceBuffer_wr;

        //  forceBuffer_rd for led and send data and ...
        //  forceBuffer_wr for next adc scan
        if (adc_scan_count_main % 2 == 0) {
            forceBuffer_rd = hwForceBuf_even;
            forceBuffer_wr = hwForceBuf_odd;
        } else {
            forceBuffer_rd = hwForceBuf_odd;
            forceBuffer_wr = hwForceBuf_even;
        }

        // uart0_printf("[%8d] copy force buf ends * ptr:%d \n", millis(), forceBuffer_wr);
    }

    adc_scan_count_main++;
}

void measure1ch(int ext_ch, int sen_ch) {
    selectPwrCh(ext_ch);
    read1chInSenMux(sen_ch);

    uart0_printf("[E%d,S%d]O:%4d, R:%4d \n", ext_ch, sen_ch, _vout_raw, _vref_raw);
}

//-----------------------------------------------------
//    MUX WORKING - DIP SW
//-----------------------------------------------------
int binDip4 = 0;
int binDip2 = 0;

#define VREF_DIP_HIGH 260  // Typically 297, 284, 287
// isLastRowConfigured : 딥스위치 측정은 먹스 설정이 되어있어야 하는데. 매트릭스 adc측정한 직후라면 설정이 되어있으므로 추가 gpio 세팅 필요없음.
void read_dipsw(bool isLastRowConfigured) { 
    // choose mux_sen #4, ch34~39
    int dip_val[NUM_OF_DIP];

    if (false == isLastRowConfigured) {
        selectPwrCh(NUM_PWR - 1);
    }

    //  _vref_raw : low is under 150 (typically 135), high is over 500 (typically 522)

    readSenCh(36);
    dip_val[0] = _vref_raw; // BOARD ID BIT 0, 0/1
    readSenCh(37);
    dip_val[1] = _vref_raw; // BOARD ID BIT 1, 0/2
    readSenCh(38);
    dip_val[2] = _vref_raw; // BOARD ID BIT 2, 0/4
    readSenCh(39);
    dip_val[3] = _vref_raw; // BOARD ID BIT 3, 0/8
    readSenCh(34);
    dip_val[4] = _vref_raw; // LOW : WIFI, HIGH : SERIAL
    readSenCh(35);
    dip_val[5] = _vref_raw; // LOW : BoardID_MAX = 1,  HIGH : BoardID_MAX = 7

    for (int i = 0; i < NUM_OF_DIP; i++) {
        if (VREF_DIP_HIGH < dip_val[i])
            dip_state[i] = HIGH;
        else
            dip_state[i] = LOW;
    }
    // uart0_printf("DIP [0]%d [1]%d [2]%d [3]%d [4]%d [5]%d\n", dip_val[0], dip_val[1], dip_val[2], dip_val[3], dip_val[4], dip_val[5]);
    // uart0_printf("DIP [0]%d [1]%d [2]%d [3]%d [4]%d [5]%d\n", dip_state[0], dip_state[1], dip_state[2], dip_state[3], dip_state[4], dip_state[5]);

    // uart0_printf("made DIP[4] LOW \n");
    // dip_state[4] = HIGH;

    binDip4 = 0;
    for (int i = 0; i < 4; i++) {
        binDip4 |= (dip_state[i] << i);
    }

    binDip2 = 0;
    for (int i = 0; i < 2; i++) {
        binDip2 |= (dip_state[4 + i] << i);
    }
}

#endif  // _CONFIGPINS_H_
