mdexdev01/MatESP32_18x11x2/prj24-luxtep-MAT_V3/pio_Luxtep_03/components/network/lib_tcpClient.h

// lib_tcpClient.h
// Version: Ver.2.2 (Cleaned up)
// Author: mdex.co.kr
// Date: 2025-07-22

#ifndef _LIB_TCPCLIENT_H_
#define _LIB_TCPCLIENT_H_

#include <WiFi.h>
#include "network_info.h"
#include "lib_nvs.h"
#include "libPrintRaw.h"

// --- Extern 변수/객체 선언 ---
extern String storedTcpServerIp;
extern String receivedTcpServerIpAddress;
extern String currentAppID;
extern PubSubClient client;
extern int board_id_hardcoding; // .ino 파일에 정의된 전역 변수 참조

// --- Extern 함수 선언 ---
void reconnectMqtt();

// --- 변수/객체 정의 ---
WiFiClient tcpClient;
const int TCP_SEND_PACKET_SIZE = 952 + 10;
const int TCP_RECV_PACKET_SIZE = 998;
const unsigned long tcpSendInterval = 10;
const unsigned long tcpConnectInterval = 3000;

int processTCP_RX(byte *rx_buf, int buf_size); // handleSerialCommand로 대체 예정. tcpReceiverTask로 이동해야 함.

// --- 함수 구현 ---
void createAndSendTcpPacket()
{
    static uint32_t sequenceNumber = 0;
    static uint8_t txBuffer[TCP_SEND_PACKET_SIZE];
/*
    txBuffer[0] = 0xFF;
    txBuffer[1] = 0xFF;
    txBuffer[2] = 0x02;
    txBuffer[TCP_SEND_PACKET_SIZE - 1] = 0xFE;

    // Client ID를 전역 변수 값으로 설정
    txBuffer[3] = board_id_hardcoding;
    txBuffer[3] = MY_BOARD_ID;
*/
    buildPacket_Sensor_1Bd(MY_BOARD_ID, packetBuf, forceBuffer_rd, SIZE_X, SIZE_Y);

    if (tcpClient.connected())
    {
        txBuffer[TCP_SEND_PACKET_SIZE - 2] = sequenceNumber % 100;
        // tcpClient.write(txBuffer, TCP_SEND_PACKET_SIZE);
        tcpClient.write(packetBuf, TCP_SEND_PACKET_SIZE);
    }
    sequenceNumber++;
}

void tcpReceiverTask(void *param)
{
    static uint8_t rxBuf[TCP_RECV_PACKET_SIZE];
    const int HEADER_LEN = 8;
    static int current_packet_len = 0; // 현재 처리 중인 패킷의 예상 총 길이
    static int bytes_received = 0;     // 현재까지 수신된 바이트 수

    while (true)
    {
        if (tcpClient.connected())
        {
            int available_bytes = tcpClient.available();
            if (available_bytes > 0)
            {
                // 1. 헤더를 기다리는 중이거나, 아직 헤더를 완전히 받지 못했을 때
                if (bytes_received < HEADER_LEN)
                {
                    int bytes_to_read = min(available_bytes, HEADER_LEN - bytes_received);
                    tcpClient.readBytes(&rxBuf[bytes_received], bytes_to_read);
                    bytes_received += bytes_to_read;
                    // uart0_printf("[TCP RX Debug] State: Reading Header. Avail: %d, Read: %d, Recv: %d\n", available_bytes, bytes_to_read, bytes_received);

                    // [DEBUG] Print rxBuf content immediately after reading header
                    // uart0_printf("[TCP RX Debug] Raw rxBuf after readBytes (partial): ");
                    // for (int i = 0; i < bytes_received; i++) {
                    //     uart0_printf("%02X ", rxBuf[i]);
                    // }
                    // uart0_printf("\n");

                    // 헤더를 완전히 수신했다면 패킷 길이를 파싱
                    if (bytes_received >= HEADER_LEN)
                    {
                        // 3. 헤더에서 가변 데이터의 길이를 추출합니다.
                        int variable_data_len = (rxBuf[6] & 0xFF) * 100 + (rxBuf[7] & 0xFF);
                        current_packet_len = HEADER_LEN + variable_data_len; // 헤더 8바이트 + 가변 데이터 (테일 포함)
                        // uart0_printf("[TCP RX Debug] Header complete. Parsed variable_data_len: %d, Total packet len: %d\n", variable_data_len, current_packet_len);

                        // 4. 전체 패킷 길이가 버퍼 크기를 초과하는지 확인
                        if (current_packet_len > TCP_RECV_PACKET_SIZE)
                        {
                            // uart0_printf("[TCP RX] Error: Packet size (%d) exceeds buffer (%d). Discarding current packet.\n", current_packet_len, TCP_PACKET_SIZE);
                            bytes_received = 0; // 버퍼 초기화
                            continue;
                        }
                    }
                }

                // 2. 헤더를 모두 받았고, 나머지 데이터를 기다리는 중일 때
                if (bytes_received >= HEADER_LEN && bytes_received < current_packet_len)
                {
                    int bytes_to_read = min(available_bytes, current_packet_len - bytes_received);
                    tcpClient.readBytes(&rxBuf[bytes_received], bytes_to_read);
                    bytes_received += bytes_to_read;
                    // uart0_printf("[TCP RX Debug] State: Reading Body. Avail: %d, Read: %d, Recv: %d\n", available_bytes, bytes_to_read, bytes_received);
                }

                // 3. 패킷을 완전히 수신했을 때
                if (bytes_received >= current_packet_len && current_packet_len > 0)
                {
                    // uart0_printf("[TCP RX] Fully received packet. Checking validity...\n");
                    // 패킷 유효성 검사 (시작/끝 마커)
                    if (rxBuf[0] == (byte)0xFF && rxBuf[1] == (byte)0xFF && rxBuf[current_packet_len - 1] == (byte)0xFE)
                    {
                        int received_client_id = rxBuf[5] & 0xFF;                // 클라이언트 ID (tx[5])
                        int sequence_num = rxBuf[current_packet_len - 2] & 0xFF; // 시퀀스 번호 (0xFE 바로 앞)

                        if (received_client_id == board_id_hardcoding || received_client_id == 8)
                        { // 8은 브로드캐스트 ID
                            uart0_printf("[TCP RX] Valid packet. Total Size: %d bytes, Client ID: %d, Sequence: %d\n", current_packet_len, received_client_id, sequence_num);
                            // uart0_printf("  Header (8 bytes): ");
                            // for (int i = 0; i < 8; i++) {
                            //     uart0_printf("%02X ", rxBuf[i]);
                            // }
                            // uart0_printf("\n");

                            // uart0_printf("  Sub Header (8 bytes): ");
                            // for (int i = 8; i < 16; i++) {
                            //     uart0_printf("%02X ", rxBuf[i]);
                            // }
                            // uart0_printf("\n");

                            // uart0_printf("  Tail (2 bytes): %02X %02X\n", rxBuf[current_packet_len - 2], rxBuf[current_packet_len - 1]);
                            processTCP_RX(rxBuf, current_packet_len);
                        }
                        else
                        {
                            uart0_printf("[TCP RX] Packet received for other Client ID (%d). Discarding content. Total Size: %d\n", received_client_id, current_packet_len);
                            // uart0_printf("  Header (8 bytes): ");
                            // for (int i = 0; i < 8; i++) {
                            //     uart0_printf("%02X ", rxBuf[i]);
                            // }
                            // uart0_printf("\n");
                        }
                    }
                    else
                    {
                        // uart0_printf("[TCP RX] Error: Invalid packet markers (Start: %02X %02X, End: %02X). Discarding.\n", rxBuf[0], rxBuf[1], rxBuf[current_packet_len - 1]);
                    }
                    bytes_received = 0;     // 패킷 처리 완료, 다음 패킷을 위해 초기화
                    current_packet_len = 0; // 패킷 길이 초기화
                }
            }
        }
        delay(1); // 다른 태스크에 시간 할당
    }
}

void loop_checkSafeTCP(){
    static unsigned long lastTcpConnectAttempt = 0;

    if (WiFi.status() != WL_CONNECTED){
        return;
    }

    if (!tcpClient.connected()){
        if (tcpConnectInterval <= millis() - lastTcpConnectAttempt){
            if (4 < storedTcpServerIp.length()){
                if (tcpClient.connect(storedTcpServerIp.c_str(), TCP_SERVER_PORT)){
                    receivedTcpServerIpAddress = storedTcpServerIp;
                    tcpClient.setNoDelay(true); // Nagle 알고리즘 비활성화
                    uart0_printf("[%8lu ms] [TCP] Connected to %s\n", millis(), receivedTcpServerIpAddress.c_str());
                }
            }

            if (!tcpClient.connected() && 4 < receivedTcpServerIpAddress.length()){
                if (tcpClient.connect(receivedTcpServerIpAddress.c_str(), TCP_SERVER_PORT)){
                    tcpClient.setNoDelay(true); // Nagle 알고리즘 비활성화
                }
            }
            lastTcpConnectAttempt = millis();
        }
    }

    reconnectMqtt();
    client.loop();
}



int processTCP_RX(byte *rx_buf, int buf_size) { // handleSerialCommand로 대체 예정. tcpReceiverTask로 이동해야 함.
    // uart_flush_input(UART_NUM_0);  // RX 버퍼 memset

    byte *currentRxBuffer = rx_buf;

    if (checkPacketHead(currentRxBuffer) == false) {
        uart0_printf("[%8d]\t read_len=%d Header BAD  %d, %d, %d, %d : %d, %d, %d, %d \n", millis(), buf_size, 
                   rx_buf[0], rx_buf[1], rx_buf[2], rx_buf[3],
                   rx_buf[4], rx_buf[5], rx_buf[6], rx_buf[7]);

        return -1;
    } else {
        uart0_printf("[%8d] RX0 Head GOOD to %d, (size=%d\n", millis(), rx_buf[IDX_MSG_ID], buf_size);
    }

    int rx_TX_BOARD_ID = rx_buf[IDX_TX_BOARD_ID];
    int rx_GROUP_ID = rx_buf[IDX_GROUP_ID];
    int rx_MSG_ID = rx_buf[IDX_MSG_ID];

    switch (rx_GROUP_ID) {
        case G_OSD_COMMAND: {  // in case uart0, it's only for the Main
            //  PARSE OSD DATA
            int ret_val = parsePacket_OSD_byMain(MY_BOARD_ID, rx_buf, rx_buf + HEAD_LEN, isSubOSD_Filled);
        } break;

        case G_APP_COMMAND: {  // NOT USE IT NOW.  it's only for the Main
            int msg_id = rx_buf[IDX_MSG_ID];
            int size_100 = rx_buf[IDX_LENGTH_100];  // OSD LENGTH / 100 (SubHeader + Body, No Tail)
            int size_1 = rx_buf[IDX_LENGTH_1];      // OSD LENGTH % 100 (SubHeader + Body, No Tail)
            int body_len = size_100 * 100 + size_1;

            currentRxBuffer = packetBuf;

            int read_len = uart_read_bytes(UART_NUM_0, currentRxBuffer, body_len, portMAX_DELAY);

/*            
            onWifiSetting = true;
            int ret_val = parsePacket_WifiApConfigInfo(rx_buf, currentRxBuffer, body_len);
            if(ret_val < 0) {
                uart0_printf("#[%8d]>> ERROR, parsePacket_WifiApConfigInfo failed with %d \n", millis(), ret_val);
                buildPacket_WifiApConfigAck(currentRxBuffer, 0);  // Send FAIL ack
            } else {
                uart0_printf("#[%8d]>> parsePacket_WifiApConfigInfo success with %d \n", millis(), ret_val);
                buildPacket_WifiApConfigAck(currentRxBuffer, 1);  // Send SUCCESS ack
            }
            sendPacket0(currentRxBuffer, HEAD_LEN + 2);  // Send ack

            onWifiSetting = false;  // Reset wifi setting flag
*/
        }break;

        case G_DEVICE_IO:      // no RX on uart0
        case G_SENSOR_DATA: {  // no RX on uart0
            return -10;
        } break;

        default:
            uart0_printf("#[%8d]>> ERROR, WRONG GROUP ID = %d \n", rx_GROUP_ID);
            return -2;
    }

    // uart0_println("Packet received successfully");

    return 0;
}


#endif // _LIB_TCPCLIENT_H_
