mdexdev01/MatESP32_18x11x2/prj24-luxtep-MAT_V3/pio_Luxtep_03/components/driver_28x35/lib_wdtimer.h

#ifndef _LIB_WDTIMER_H_
#define _LIB_WDTIMER_H_

#include "esp_system.h"

int TIMER_DUR_MS = 200;   // 500ms
const int MStoUM = 1000;  // time in ms to trigger the watchdog
hw_timer_t* timer = NULL;

int timer_count = 0;
int timer_count_used = 0;

void ARDUINO_ISR_ATTR onTimer() {
    timer_count++;

    // ets_printf("isr[wdt] %d, (%d) \n", timer_count, millis());
}

int getTimerToken() {
    return (timer_count - timer_count_used);
}

int clearTimerToken() {
    timer_count_used = timer_count;
    return 0;
}

int consumeTimerToken() {
    int tokens = timer_count - timer_count_used;
    timer_count_used = timer_count;
    return tokens;
}

void setup_wdTimer() {
    timer = timerBegin(0, 80, true);                      // timer 0, div 80
    timerAttachInterrupt(timer, &onTimer, true);          // attach callback
    timerAlarmWrite(timer, MStoUM * TIMER_DUR_MS, true);  // set time in us
    timerAlarmEnable(timer);                              // enable interrupt
}

void loop_wdTimer() {
    // timerWrite(timer, 0);  // reset timer (feed watchdog)
    // long loopTime = millis();
    {
        // do something with timer
    }
    // loopTime = millis() - loopTime;
    // Serial.print("loop time is = ");
    // uart0_println(loopTime);  // should be under 3000
}

void changeTimerDurMS(int milliSecond) {
    timerAlarmWrite(timer, milliSecond * MStoUM, true);  // set time in us
}

void changeTimerDurUS(int microSecond) {
    timerAlarmWrite(timer, microSecond, true);  // set time in us
}

#endif  // _LIB_WDTIMER_H_
