mdexdev01/MatESP32_18x11x2/krri-16x20x2-alpha/Proc_KRRI_Footstep/taskUI.pde

ControlP5 cp5; // https://sojamo.de/libraries/controlP5/

//---------------------------------------------
//  UI coordinate
int window_width = 1400;
int window_height = 900;

int division_r_w = 210;
int division_b_h = 100;

int offset_x = window_width - division_r_w;
int offset_y = 30;
int margin_w = 15;
int margin_h = 35;


EditRect  erCopi_L;
EditRect  erCopi_R;


String strPathCSV = "CSV_Data/";
String strPathShot = "ScreenShot/";

String strFooterCSV = ".csv";
String strFooterShot = ".png";

String strFileInfo;
EditRect  erFileName;


Textlabel    textTimer;

ControlTimer lapTimer;
long         tickOrigin;
long last_grant_tick = 0;

void setup_Timer() {
  lapTimer = new ControlTimer();
  lapTimer.setSpeedOfTime(1); // 1 : 1ms

  tickOrigin = lapTimer.time();
  last_grant_tick = 0;
}

void reset_Timer() {
  tickOrigin = lapTimer.time();
  last_grant_tick = 0;
}

void updateGrant_Timer(long grant_tick) {
  last_grant_tick = grant_tick;
}

long getLastGrant_Timer() {
  return last_grant_tick;
}

long getElapsedTick_Timer() {
  return (lapTimer.time() - tickOrigin);
}

String getCurTimeString() {
  int d = day();    // Values from 1 - 31
  int mo = month();  // Values from 1 - 12
  int y = year();   // 2003, 2004, 2005, etc.

  int s = second();  // Values from 0 - 59
  int m = minute();  // Values from 0 - 59
  int h = hour();    // Values from 0 - 23
  
  String time_string = String.format("%4d%02d%02d-%02d%02d%02d", y, mo, d, h, m, s);
  
  return time_string;  
}


PImage    bgi_logo_120ch; // Background image
PImage    bgi_logo_mdex; // Background image

void setup_UI() {

  bgi_logo_120ch = loadImage("./res/logo_Title.png");
  image(bgi_logo_120ch, window_size_x - 300, 0);
  // image(bgi_logo_120ch, 15, -25);


  bgi_logo_mdex = loadImage("./res/logo_mdex(kor).png");
  image(bgi_logo_mdex, window_size_x - 220, window_size_y - 50);

  setup_Timer();
  setup_cp5();
}

void setup_cp5() {
  //----------------------------------------
  //  ControlP5
  //  https://www.sojamo.de/libraries/controlP5/#examples
  cp5 = new ControlP5(this);
  
  PFont font_small = createFont("arial",14);
  PFont font_mid   = createFont("arial",24);
  PFont font_large = createFont("arial",40);
  //  align controls
  int pos_x = 120;
  int pos_y = 100;
  

  textTimer = new Textlabel(cp5,"--",100,100);
  textTimer.setPosition(pos_x, pos_y);

  //----------------------------------------
  //  SERIAL PORT
  {
    // pos_x = window_width / 2 - 180;
    pos_x = window_size_x - 230;
    pos_y = 80;

    EditRect lineRect = new EditRect(pos_x-10, pos_y, 3, window_size_y - pos_y);
    lineRect.render();


    pos_y = 150;
    cp5.addTextlabel("label_Serial")
                      .setText("Serial Port :")
                      .setPosition(pos_x, pos_y)
                      .setColorValue(0xff555555)
                      .setFont(createFont("Arial",14))
                      //.setFont(font_small)
                      ;
    
    // pos_y += 8;
    cp5.addTextfield(SerialNoteLabel)
        .setPosition(pos_x + 90, pos_y)
        .setSize(30,25)
        .setText(userPref.getValue(userPref.itemPort))
        .setFont(createFont("Arial",12))
        //.setFont(font)
        .setFocus(true)
        .setColor(color(0, 0, 100))
        ;

    cp5.addButton("OPEN SERIAL").setPosition(pos_x + 130, pos_y).setSize(55, 25).setLabel("Open").setFont(createFont("Arial",14));

  }
  
  //----------------------------------------
  //  FILE NAME
  {
    // pos_x = 5;
    pos_y = window_size_x - 350;

    int control_width = 0;
    
    control_width = 90;
    cp5.addTextlabel("tag_FILENAME")
                      .setText("File Name(Eng) :")
                      .setPosition(pos_x, pos_y)
                      .setColorValue(0xff0060ff)
                      .setFont(font_small)
                      ;

    // pos_x += control_width + 25;
    pos_y += 30;
    control_width = 180;
    cp5.addTextfield("NAME")
        .setPosition(pos_x, pos_y).setSize(control_width-50, 25)
        .setText("John Doe")
        .setFont(font_small)
        .setColor(color(0, 0, 100))
        ;
    
    // pos_x += control_width - 35;
    pos_y += 50;
    control_width = 70;
    cp5.addTextfield("MEMO")
        .setPosition(pos_x, pos_y).setSize(control_width, 25)
        .setText("MEMO")
        .setFont(font_small)
        .setColor(color(0, 0, 100))
        ;

    control_width = 230;

    // pos_x = 100 + 250;
    pos_y += 70;
    // cp5.addTextlabel("_SaveFileName")
    //                  .setText("TIME_NAME_GENDER_AGE_WEIGHT_FOOTLENGTH.csv")
    //                  .setPosition(pos_x, pos_y)
    //                  .setColorValue(0xff606060)
    //                  .setFont(font_small)
    //                  ;

    control_width = 200;

    erFileName = new EditRect(pos_x, pos_y, control_width, 22);
    erFileName.setFontSize(16);
    erFileName.setTextLeftMargin(2);
    erFileName.setTextTopMargin(13);
    // erFileName.showString("Hello");
  }

  //----------------------------------------
  //  SCREEN SHOT, SAVE CSV
  {
    // pos_x = window_size_x - 650;
    // pos_x = 15;
    pos_y +=  40;
    cp5.addButton("Screen shot").setPosition(pos_x, pos_y).setSize(200, 70)
                    .setLabel("Screen shot").setFont(font_mid);

    pos_y += 80;
    cp5.addButton(CSV_BTN_TAG).setPosition(pos_x, pos_y).setSize(200, 70)
                    .setLabel(CSV_BTN_FALSE).setFont(font_mid);

    csv_btn_state = false;

  }



}

boolean csv_btn_state = false;
//String SerialNoteLabel = "Serial Port (Number only)";
String SerialNoteLabel = "(Number only)";

String CSV_BTN_TAG    = "CSV_START_STOP";
String CSV_BTN_FALSE  = "SAVE DATA";
String CSV_BTN_TRUE   = "STOP";



///////////////////////////////////////////////////////////////////////////
//    EVENT HANDLER
///////////////////////////////////////////////////////////////////////////
void fileSelected(File selection) {
  if (selection == null) {
    println("Window was closed or the user hit cancel.");
  } else {
    println("User selected " + selection.getAbsolutePath());
  }
}


void controlEvent(CallbackEvent event) {
  String strBuf;
  boolean result;
  int value_i;
  float value_f;

  if (event.getAction() == ControlP5.ACTION_CLICK) {
    switch(event.getController().getAddress()) {
      case "/OPEN SERIAL":
        println("OPEN SERIAL");
        strBuf = cp5.get(Textfield.class, SerialNoteLabel).getText();
        println("Button open Pressed : " + strBuf);
        
        String comNames = String.format("COM%s", strBuf);
        println("Port Name : " + comNames);
        
        openSerialPort(comNames);

        //sunixStartPort = Integer.parseInt(strBuf);;
        //open_Serial(sunixStartPort);
        
        userPref.setValue(userPref.itemPort, strBuf);
        userPref.saveTable_CSV();
        
        cp5.get(Textfield.class, SerialNoteLabel).setLock(true);
        event.getController().setColorValue(0x5e5e5e);
        //event.getController().setLock(true);

        break;

      case "/CSV_START_STOP":
        println("CSV_START_STOP");
        if(false == isPortOpened) {
          strBuffer = "Can't save. Please open serial port";

          drawTextLog(strBuffer);
          println(strBuffer);
          
          break;
        }

        //  toggle button state and text
        if(false == csv_btn_state) {
          //  SAVE ON
          csv_btn_state = true;
          event.getController().setLabel(CSV_BTN_TRUE);
          saveCSV_open();
          
          reset_Timer();
        }
        else {
          //  SAVE OFF
          csv_btn_state = false;
          event.getController().setLabel(CSV_BTN_FALSE);
          
        }
        break;

      case "/Screen shot":
        println("Screen shot");
        String text_field = cp5.get(Textfield.class, "NAME").getText();

        //String temp_str = "./capture/bebe_V01_" + getCurTimeString() + ".png";
        String temp_str = strPathShot + "/" + text_field + "/" + getCurTimeString() + "_" + strFileInfo + ".png";
        println(temp_str);
        saveFrame(temp_str);
        //cp5.getProperties().saveSnapshot("hello1");

        // selectInput("Select a file to process:", "fileSelected");

        break;
        
      case "/tag_COPI_L":
        float value = event.getController().getValue();

        println("tag_COPI_L --> " + value);
        break;
    }
    println("ui handler ended...");
  }
}


int update_count = 0;
int COPI_DIV_L = 0;
int COPI_DIV_R = 0;

void update_UI() {
    push();

    //stroke(250);
    ////line(950, 0, 950, window_height);
    //line(dashboard_x, 0, dashboard_x, window_height);

    String text_field;
    
    strFileInfo = "";
    
    text_field = cp5.get(Textfield.class, "NAME").getText();
    strFileInfo += text_field;
    
    text_field = "_" + cp5.get(Textfield.class, "MEMO").getText();
    strFileInfo += text_field;
    
    
    erFileName.render();
    erFileName.showString(strFileInfo);


    pop();

    update_count++;
}
