mdexdev01/MatESP32_18x11x2/(commit log)

2023-03-19 Launched
    Ver.1
    [CellPos_Block_A.csv, CellPos_Block_B.csv, Preference.csv]
2023-05-13 32 x 22 via wifi
    [CellPos_Block_A.csv, CellPos_Block_B.csv, Preference.csv]
2023-05-13 project begins - esp32 to cloud
2023-05-13 project begins - esp32 to iot cloud
2023-07-06 설치가이드
2023-07-06 Create Processing 설치가이드.txt
2023-07-15 16 x 11 - Backup before BLE, RLE. (Only main, not sub)
    16 x 11 중간 단계. (메인만 적용. 서브는 적용 안됨)
    BLE advertise 테스트됨. (미적용)
    RLE 테스트됨 (미적용)
    [CellPos_Block_A.csv, CellPos_Block_B.csv]
2023-07-28 Start with 75cm board
2023-08-05 works good. 16 x 11 no rle
    [Preference.csv]
2023-08-06 rle integrated. just before ble
    [CellPos_Block_A.csv, CellPos_Block_B.csv]
2023-08-11 adv, esp32 2.0.11
2023-08-15 integrated rle (Top + Bottom mat), Timer 500ms, No tx while cutoff
2023-08-30 CSV 저장 기능 활성화
2023-10-10 Release231010-코엑스 전시회
2023-11-24 KRRI launch
    [CellPos_Block_A.csv, CellPos_Block_B.csv, CellPos_Block_C.csv, Preference.csv]
2023-11-25 to make timer compact, to change cell position, save
    [CellPos_Block_A.csv, CellPos_Block_B.csv, CellPos_Block_C.csv]
2023-11-27 12채널 원복
    [CellPos_Block_A.csv, CellPos_Block_B.csv, CellPos_Block_C.csv, Preference.csv]
2024-02-12 Initialize this project
    [CellPos_Block_A.csv, CellPos_Block_B.csv, CellPos_Block_C.csv, Preference.csv]
2024-06-14 Ezgeo 프로젝트 Processing origin
    [Preference.csv, winnieconnie.csv]
2024-06-14 ESP32-S3- Timer app
2024-06-14 esp32 s3 for ezgeo start
2024-06-18 2. libPacket 함수들을 libMatrixView 클래스에 fillData함수로 편입. 3. matView_A를 레퍼런스로 참조. 4. SerialPort 객체화
2024-06-20 이지지오 패킷 V.1.1
    [Preference.csv]
2024-08-23 브랜드콘텐츠 릴리즈
    [Preference.csv, winnieconnie.csv]
2024-08-23 이지지오 릴리즈 240810
    [Preference.csv]
2024-08-30 RS485-3채널 동작
    [Preference.csv, brandcontentsA.csv, brandcontentsB.csv, brandcontentsC.csv]
2024-08-31 성공-3block 통신, buadrate 1M
    [brandcontentsA.csv, brandcontentsB.csv, brandcontentsC.csv]
2024-08-31 브랜드콘텐츠 - 버그픽스, 1번과 2번 보드가 논리적으로 정확히 메시지를 받은후 전송하도록. 전송 주기 33mm확정.
    [Preference.csv]
2024-09-06 브랜드콘텐츠 릴리즈 완료. 프로세싱 완료 (3block) baudrate 2M
    [Preference.csv, brandcontentsA.csv, brandcontentsB.csv, brandcontentsC.csv, brandcontentsD.csv]
2024-09-20 ESP32 changed BSP (V.2.0.14 --> V.3.0)
2024-09-29 lgdisplay 방수, 12비트 측정 릴리즈
    [20240926-130014_John Doe_MEMO.csv, Preference.csv, lgd_A.csv, lgd_B.csv, lgd_C.csv, lgd_D.csv]
2025-01-07 lgd release
    [20241024-172548_LGD_Line3_Pos2.csv, Preference.csv]
2025-01-07 esp32-s3 comps
2025-01-07 rename the proc folder (remove)
    [Preference.csv, brandcontentsA.csv]
2025-01-07 rename the proc folder (new)
    [Preference.csv, brandcontentsA.csv]
2025-03-23 base of V02 - arduino ide
2025-03-23 base of V02 - Processing
    [Preference.csv, brandcontentsA.csv]
2025-04-17 uart rx fifo threshold size: 120 --> 96
2025-08-03 ota, mqtt 안정성 향상
